Leenix/NodeMLX/README.md

# NodeMLX
Embedded Arduino-based thermal tracking with a NodeMCU and a Melexis MLX90621 thermopile array sensor.
