Leenix/NodeMLX/PCB/NodeMLX.kicad_pcb

## KiCad design PCB/NodeMLX.kicad_pcb (2017-04-28)

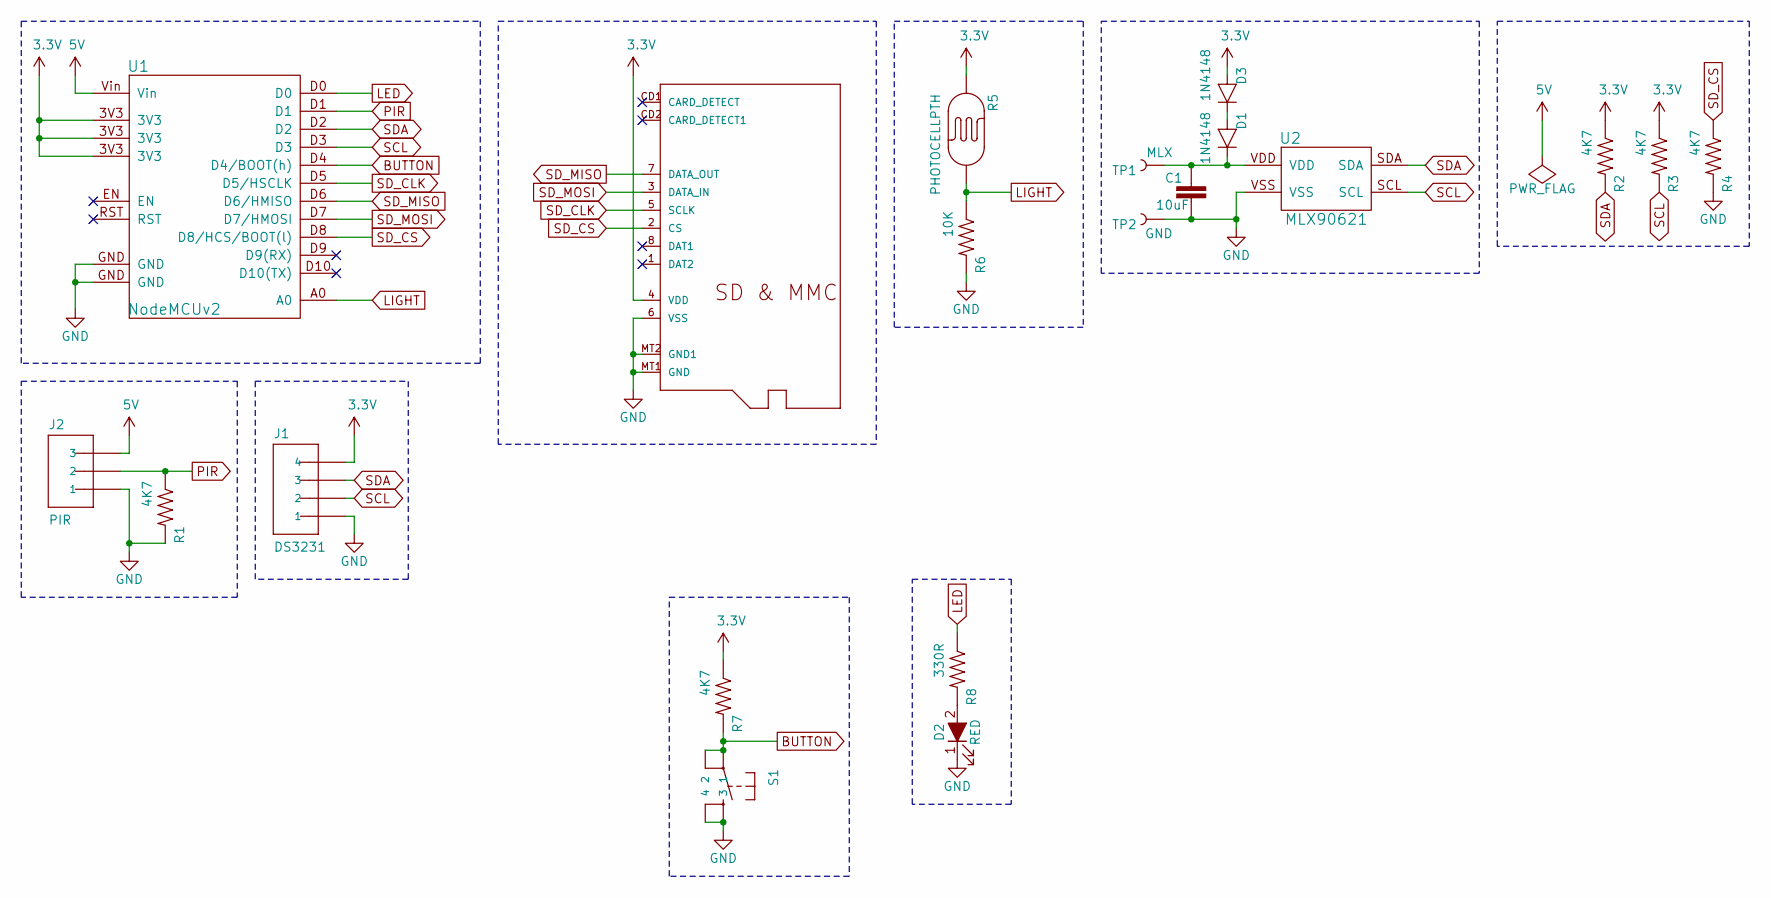
[picture p1: schematic NodeMLX.sch]

Parts:
C1: 10uF; C_1206
D1, D3: 1N4148; D_SOD-123
D2: RED; LED_1206
J1: DS3231; Pin_Header_Angled_1x04_Pitch2.54mm
J2: PIR; Pin_Header_Angled_1x03_Pitch2.54mm
M1: MICROSD
R1, R2, R3, R4, R7: 4K7; R_1206
R5: PHOTOCELLPTH; PHOTOCELL
R6: 10K; R_1206
R8: 330R; R_1206
S1: TAC_SWITCHSMD; TACTILE-SWITCH-SMD
TP1: MLX; PAD.02X.02
TP2: GND; PAD.02X.02
U1: NodeMCUv2; nodemcuv2
U2: MLX90621; mlx90621

Connections:
3.3V: D3.2 (A), J1.4, M1.4 (VDD), R2.1, R3.1, R5.1, R7.1, U1.3V3
5V: J2.3, U1.Vin
BUTTON: R7.2, S1.1, S1.2, U1.D4 (D4/BOOT(h))
GND: C1.2, D2.1 (K), J1.1, J2.1, M1.6 (VSS), M1.MT1 (GND), M1.MT2 (GND1), R1.2, R4.2, R6.2, S1.3, S1.4, TP2.P$1, U1.GND, U2.VSS
LED: R8.1, U1.D0
LIGHT: R5.2, R6.1, U1.A0
unnamed: C1.1, D1.1 (C), TP1.P$1, U2.VDD
unnamed: D1.2 (A), D3.1 (C)
unnamed: D2.2 (A), R8.2
PIR: J2.2, R1.1, U1.D1
SCL: J1.2, R3.2, U1.D3, U2.SCL
SDA: J1.3, R2.2, U1.D2, U2.SDA
SD_CLK: M1.5 (SCLK), U1.D5 (D5/HSCLK)
SD_CS: M1.2 (CS), R4.1, U1.D8 (D8/HCS/BOOT(l))
SD_MISO: M1.7 (DATA_OUT), U1.D6 (D6/HMISO)
SD_MOSI: M1.3 (DATA_IN), U1.D7 (D7/HMOSI)

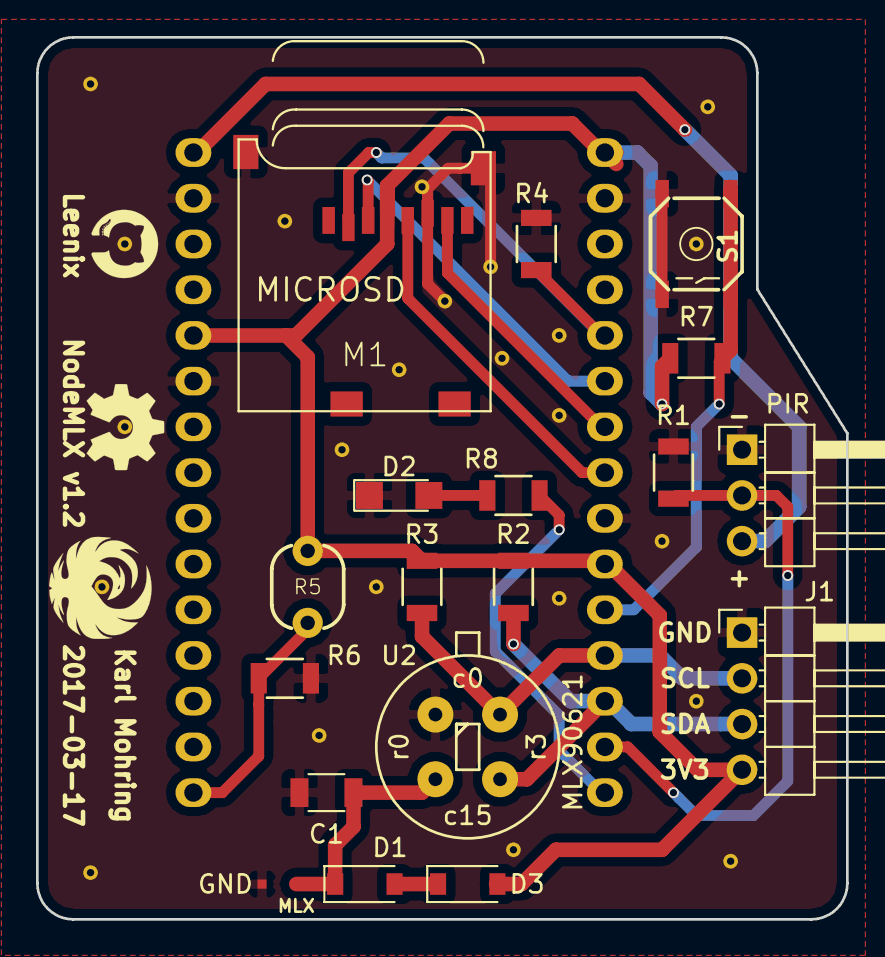
[picture p2: board NodeMLX.kicad_pcb from above]

Board: 2 copper layers, 45.0 x 49.0 mm, 20 parts (1 on the bottom side), 16 nets.
