Leenix/NodeMLX/(commit log)

2017-01-13 Added PCB files
    [NodeMLX.GBL, NodeMLX.GBO, NodeMLX.GBP, NodeMLX.GBS, NodeMLX.GTL, NodeMLX.GTO, NodeMLX.GTP, NodeMLX.GTS]
2017-02-03 Version 1.1 update - Lots of changes to sensors + Firmware updated to v1.1 to suit the extra kit + WiFi uploading added to firmware + Add SD card socket + Added RTC + Added LDR light sensor + Added b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
    [NodeMLX.GBL, NodeMLX.GBO, NodeMLX.GBP, NodeMLX.GBS, NodeMLX.GTL, NodeMLX.GTO, NodeMLX.GTP, NodeMLX.GTS]
2017-03-20 Fixed PCB. Added html generators for live map
    [NodeMLX.kicad_pcb, NodeMLX.sch]
2017-04-28 Fixed PCB; added callbacks
    [NodeMLX-B.Cu.gbl, NodeMLX-B.Mask.gbs, NodeMLX-B.SilkS.gbo, NodeMLX-Edge.Cuts.gm1, NodeMLX-F.Cu.gtl, NodeMLX-F.Mask.gts, NodeMLX-F.SilkS.gto, NodeMLX.drl]
2017-06-06 Massive changes. - Added web interface to change all tracking variables - All tracking variables are now mutable at runtime - Reworked tracking penalties - Reworked track reporting with callbacks - D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
    [NodeMLX.ino]
2017-06-08 - Fixed Wifi connection bug - Resorted penalties - Hopefully fixed direction penalty bug
    [NodeMLX.ino]
2017-08-24 Added dead frame penalty to tracking - Lost blobs that disappear between frames should now be recoverable
2017-08-25 Merged dead frame tracking - Colourised main menu - Added background frame monitoring - Added processing frame rate - Fixed bug with setting dead frame limit - Fixed bug copying dead frame tracking w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
    [NodeMLX.ino]
2017-08-28 Added dead frame info to debug
